faridpis/Electric-Guitar-Amplifier/README.md

# Electric-Guitar-Amplifier
Design, simulation, assembly, troubleshooting, and coordination of an electric Guitar amplifier circuit board, including component ordering, soldering, and functional testing.
