faridpis/Electric-Guitar-Amplifier/project files/Mi_Teoman_Farid_Amp_v3.kicad_pcb

## KiCad design project files/Mi_Teoman_Farid_Amp_v3.kicad_pcb (2026-05-09)

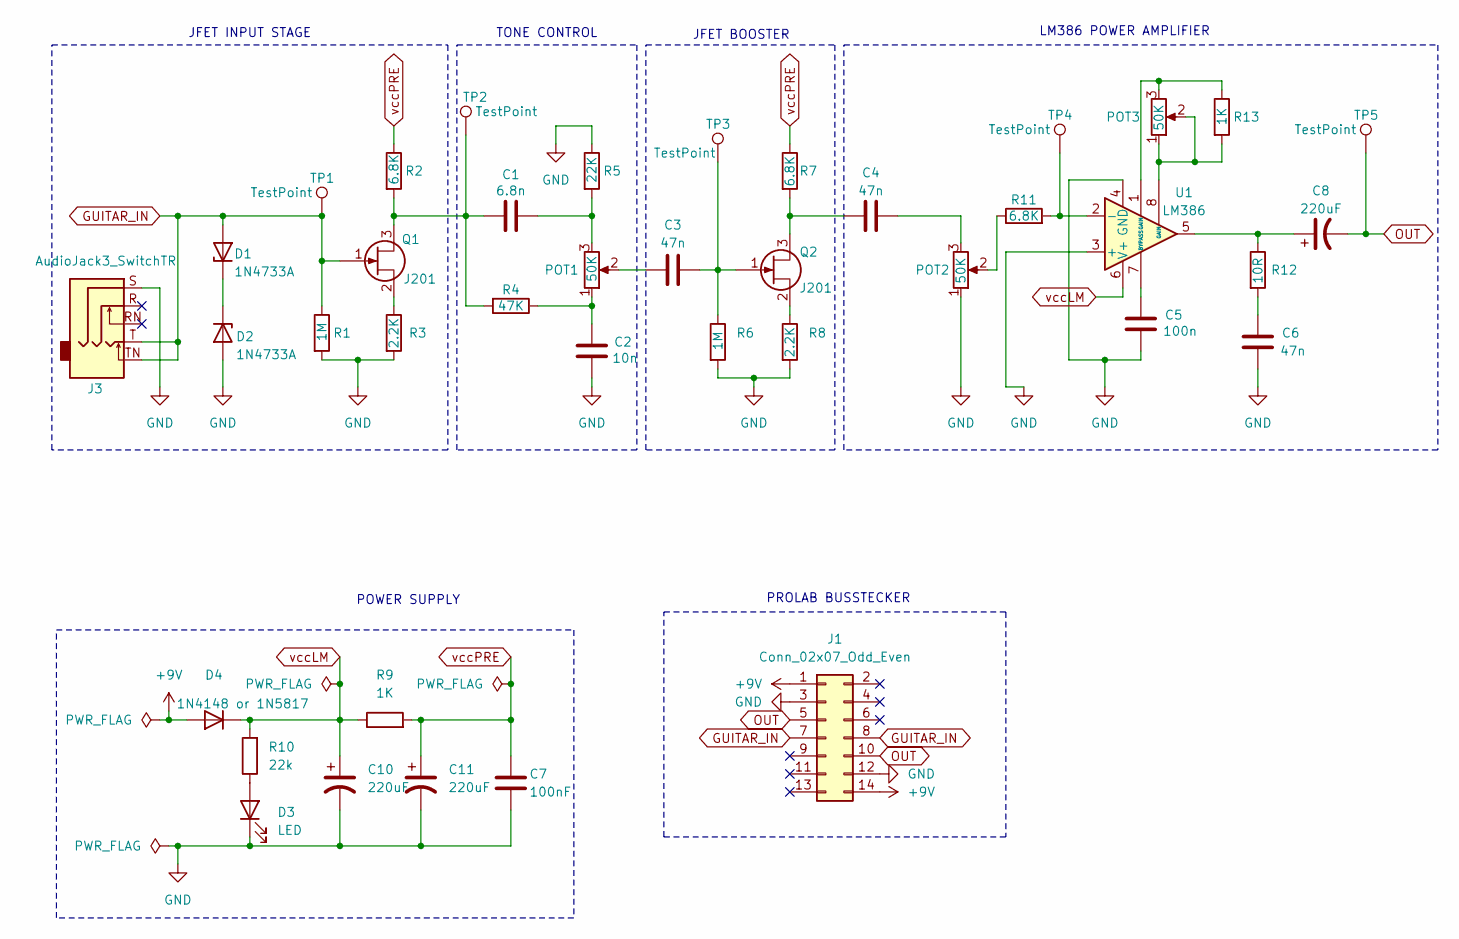
[picture p34: schematic Mi_Teoman_Farid_Amp_v3.kicad_sch]

Parts:
C1: 6.8n; C_Disc_D4.3mm_W1.9mm_P5.00mm
C2: 10n; C_Disc_D4.3mm_W1.9mm_P5.00mm
C3, C4, C6: 47n; C_Disc_D4.3mm_W1.9mm_P5.00mm
C5: 100n; C_Disc_D4.3mm_W1.9mm_P5.00mm
C7: 100nF; C_Disc_D4.3mm_W1.9mm_P5.00mm
C8, C10, C11: 220uF; C_Radial_D10.0mm_H12.5mm_P5.00mm
D1, D2: 1N4733A; D_DO-41_SOD81_P10.16mm_Horizontal
D3: LED; LED_D3.0mm_IRBlack
D4: 1N4148 or 1N5817; D_DO-35_SOD27_P7.62mm_Horizontal
J1: Conn_02x07_Odd_Even; Busstecker
J3: AudioJack3_SwitchTR; Jack_3.5mm_CUI_SJ1-3515N_Horizontal
POT1, POT2, POT3: 50K; Potentiometer_Alps_RK163_Single_Horizontal
Q1, Q2: J201; TO-92L_Inline_Wide
R1, R6: 1M; R_Axial_DIN0207_L6.3mm_D2.5mm_P10.16mm_Horizontal
R2, R7, R11: 6.8K; R_Axial_DIN0207_L6.3mm_D2.5mm_P10.16mm_Horizontal
R3, R8: 2.2K; R_Axial_DIN0207_L6.3mm_D2.5mm_P10.16mm_Horizontal
R4: 47K; R_Axial_DIN0207_L6.3mm_D2.5mm_P10.16mm_Horizontal
R5: 22K; R_Axial_DIN0207_L6.3mm_D2.5mm_P10.16mm_Horizontal
R9, R13: 1K; R_Axial_DIN0207_L6.3mm_D2.5mm_P10.16mm_Horizontal
R10: 22k; R_Axial_DIN0207_L6.3mm_D2.5mm_P10.16mm_Horizontal
R12: 10R; R_Axial_DIN0207_L6.3mm_D2.5mm_P10.16mm_Horizontal
TP1, TP2, TP3, TP4, TP5: TestPoint; TestPoint_Pad_D2.0mm
U1: LM386; DIP-8_W7.62mm_Socket_LongPads

Connections:
+9V: D4.2 (A), J1.1, J1.14
GND: C2.2, C5.2, C6.2, C7.2, C10.2, C11.2, D2.2 (A), D3.1 (K), J1.3, J1.12, J3.S, POT2.1, R1.2, R3.2, R5.1, R6.2, R8.2, U1.3 (+), U1.4 (GND)
GUITAR_IN: D1.2 (A), J1.7, J1.8, J3.T, J3.TN, Q1.1 (G), R1.1, TP1.1
unnamed: C1.2, POT1.3, R5.2
unnamed: C2.1, POT1.1, R4.1
unnamed: C3.1, POT1.2
unnamed: C4.2, POT2.3
unnamed: C6.1, R12.2
unnamed: C8.1, R12.1, U1.5
unnamed: D1.1 (K), D2.1 (K)
unnamed: D3.2 (A), R10.1
unnamed: POT2.2, R11.1
unnamed: POT3.1, POT3.2, R13.2, U1.8 (GAIN)
unnamed: POT3.3, R13.1, U1.1 (GAIN)
unnamed: C1.1, Q1.3 (D), R2.2, R4.2, TP2.1
unnamed: Q1.2 (S), R3.1
unnamed: C4.1, Q2.3 (D), R7.2
unnamed: C3.2, Q2.1 (G), R6.1, TP3.1
unnamed: Q2.2 (S), R8.1
unnamed: R11.2, TP4.1, U1.2 (-)
unnamed: C5.1, U1.7 (BYPASS)
OUT: C8.2, J1.5, J1.10, TP5.1
vccLM: C10.1, D4.1 (K), R9.1, R10.2, U1.6 (V+)
vccPRE: C7.1, C11.1, R2.1, R7.1, R9.2

Notes on the sheet:
PROLAB BUSSTECKER
LM386 POWER AMPLIFIER
JFET BOOSTER
JFET INPUT STAGE
TONE CONTROL
POWER SUPPLY

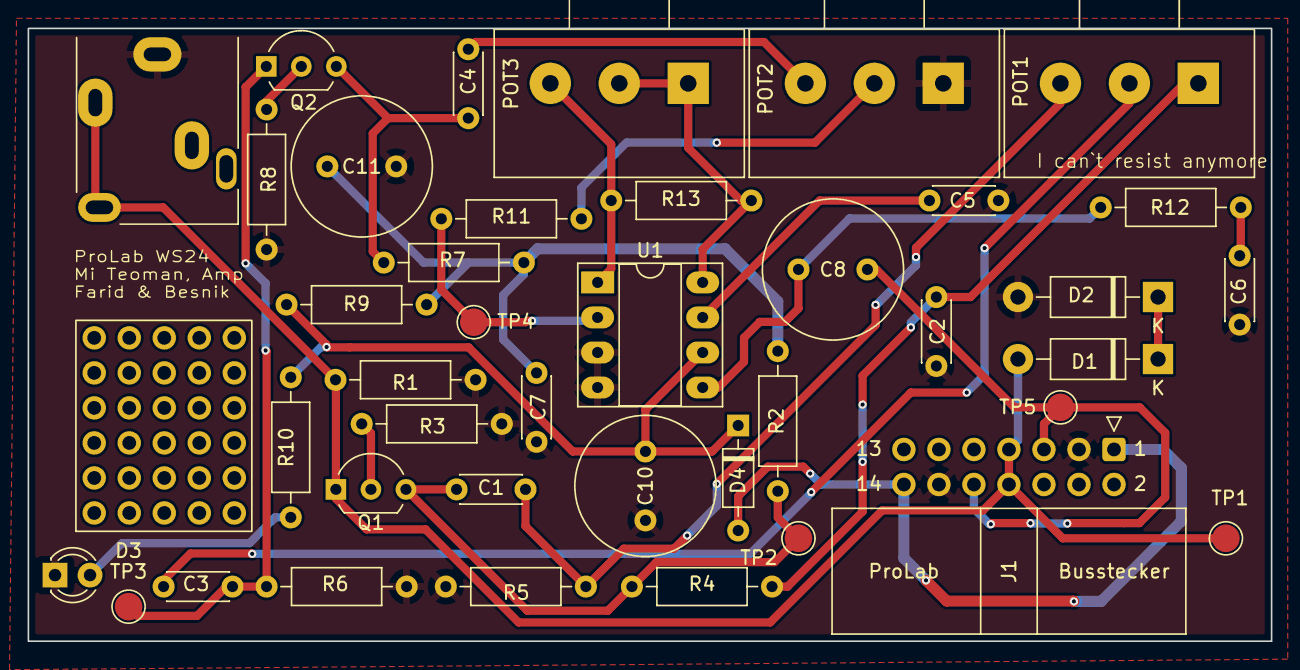
[picture p35: board Mi_Teoman_Farid_Amp_v3.kicad_pcb from above]

Board: 2 copper layers, 90.2 x 44.5 mm, 40 parts (0 on the bottom side), 24 nets.
